helioz2000/RAY_power/Board/IMG_2490.jpg

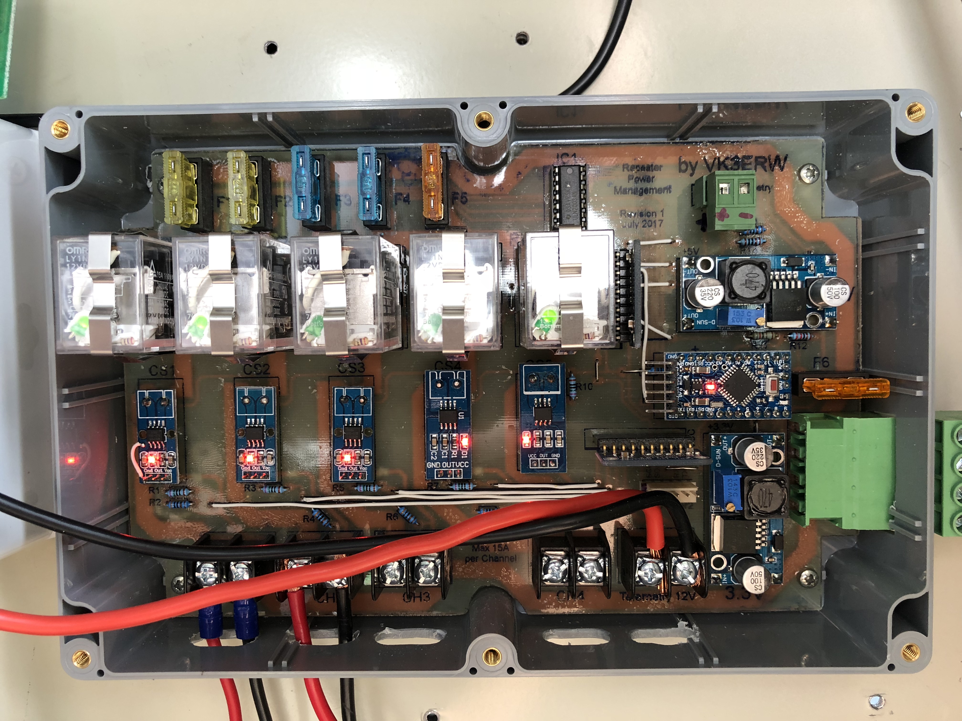
Board/IMG_2490.jpg
