helioz2000/RAY_power/Board/RaPiCable.pdf

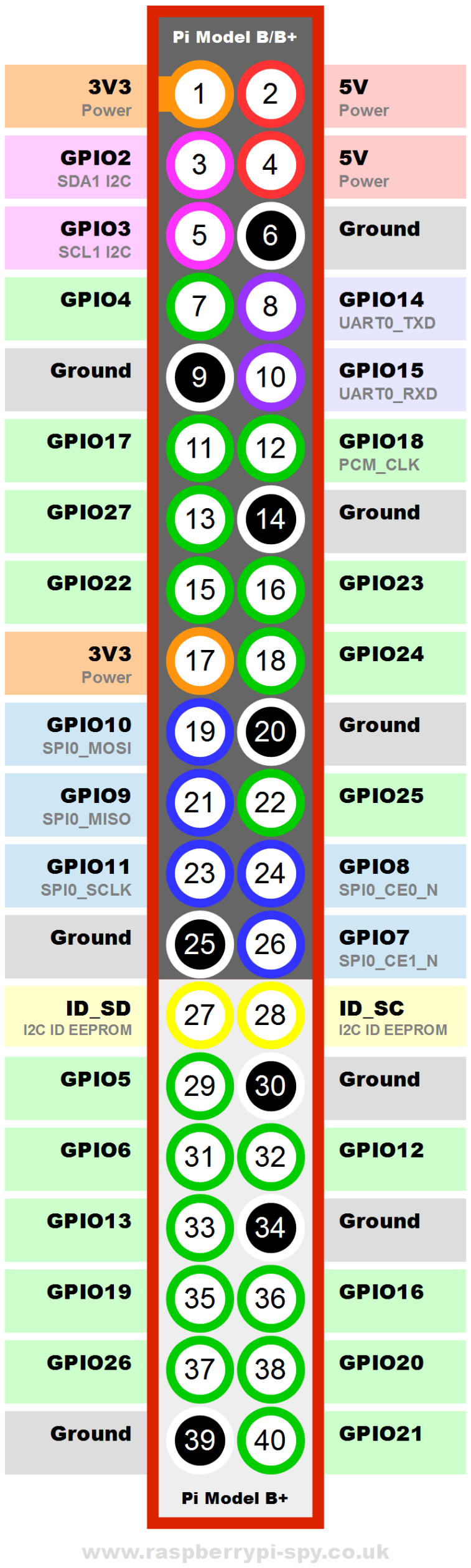
[picture p2: figure]

RaPi | Pwr
1 (NC) 5 | -> | 2 (SCL) 3 | -> | 3 (SDA) 6 | -> | 4 (GND) 8 | -> | 5 (RX)
10 | -> | 6 (TX)

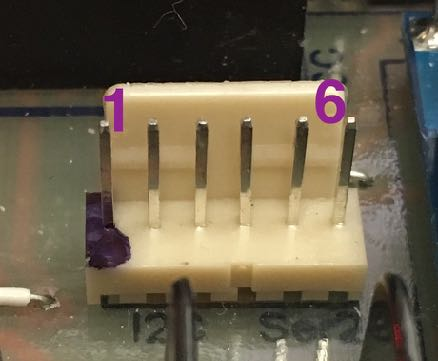
[picture p3: figure]
