helioz2000/RAY_power/Board/RAY_PWR_PartsList.rtf

R1 | 750 | Jaycar
R2 | 3k | Jaycar
R3 | 750 | Jaycar
R4 | 3k | Jaycar
R5 | 750 | Jaycar
R6 | 3k | Jaycar
R7 | 750 | Jaycar
R8 | 3k | Jaycar
R9 | 3k | Jaycar
R10 | 750 | Jaycar
R11 | 8.2k | Jaycar
R12 | 2.2k | Jaycar
R13 | 3k | Jaycar
R14 | 1k | Jaycar
RLY1 | LY1N-DC12 | Omron
RLY2 | LY1N-DC12 | Omron
RLY3 | LY1N-DC12 | Omron
RLY4 | LY1N-DC12 | Omron
RLY5 | MY2N-DC12 | Omron
IC1 | ULN2003AN | Texas Inst.
B1 | Pro Mini 8Mhz 3.3V | Arduino
B2 | ADS1115 | Adafruit
B2 | ADS1115 | Adafruit
B3 | 5V Buck Converter | gowin_electronic (ebay)
B3 | 3.3V Buck Converter | gowin_electronic (ebay)
