helioz2000/RAY_power/Board/RAY_pwr_components.pdf

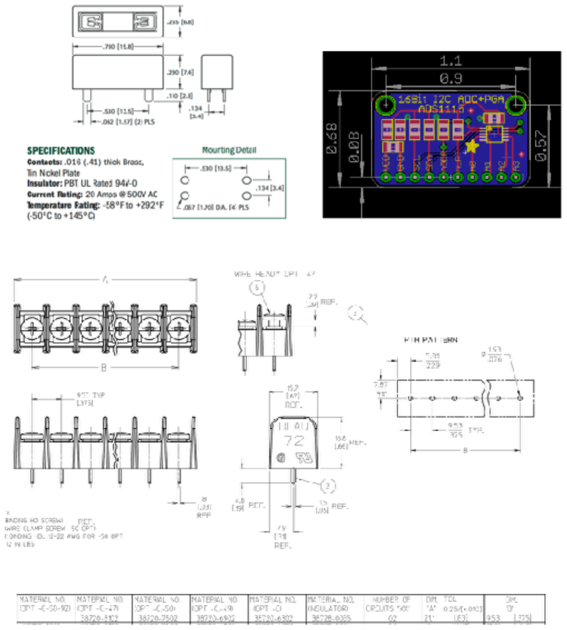
[picture p4: page 1]
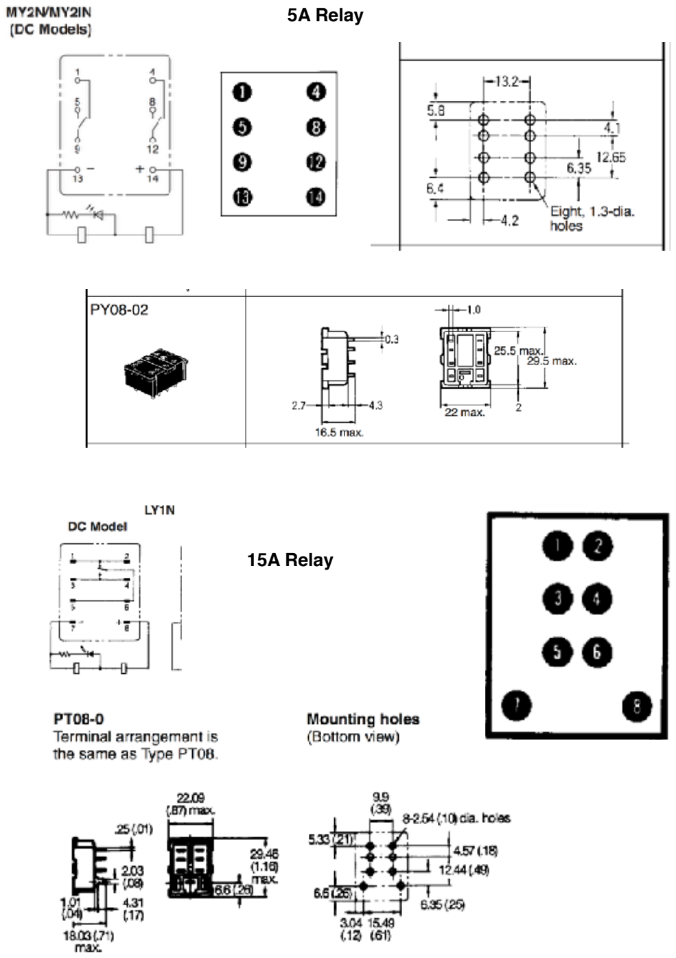
[picture p5: page 2]

15A Relay

5A Relay
