helioz2000/RAY_power/(list of files, cad)

Other CAD files:
Board/RAYPWR_DrillTemplate.dwg
Board/RAY_PWR_PCB.dwg
