helioz2000/RAY_power/Board/ray_pwr.pdf

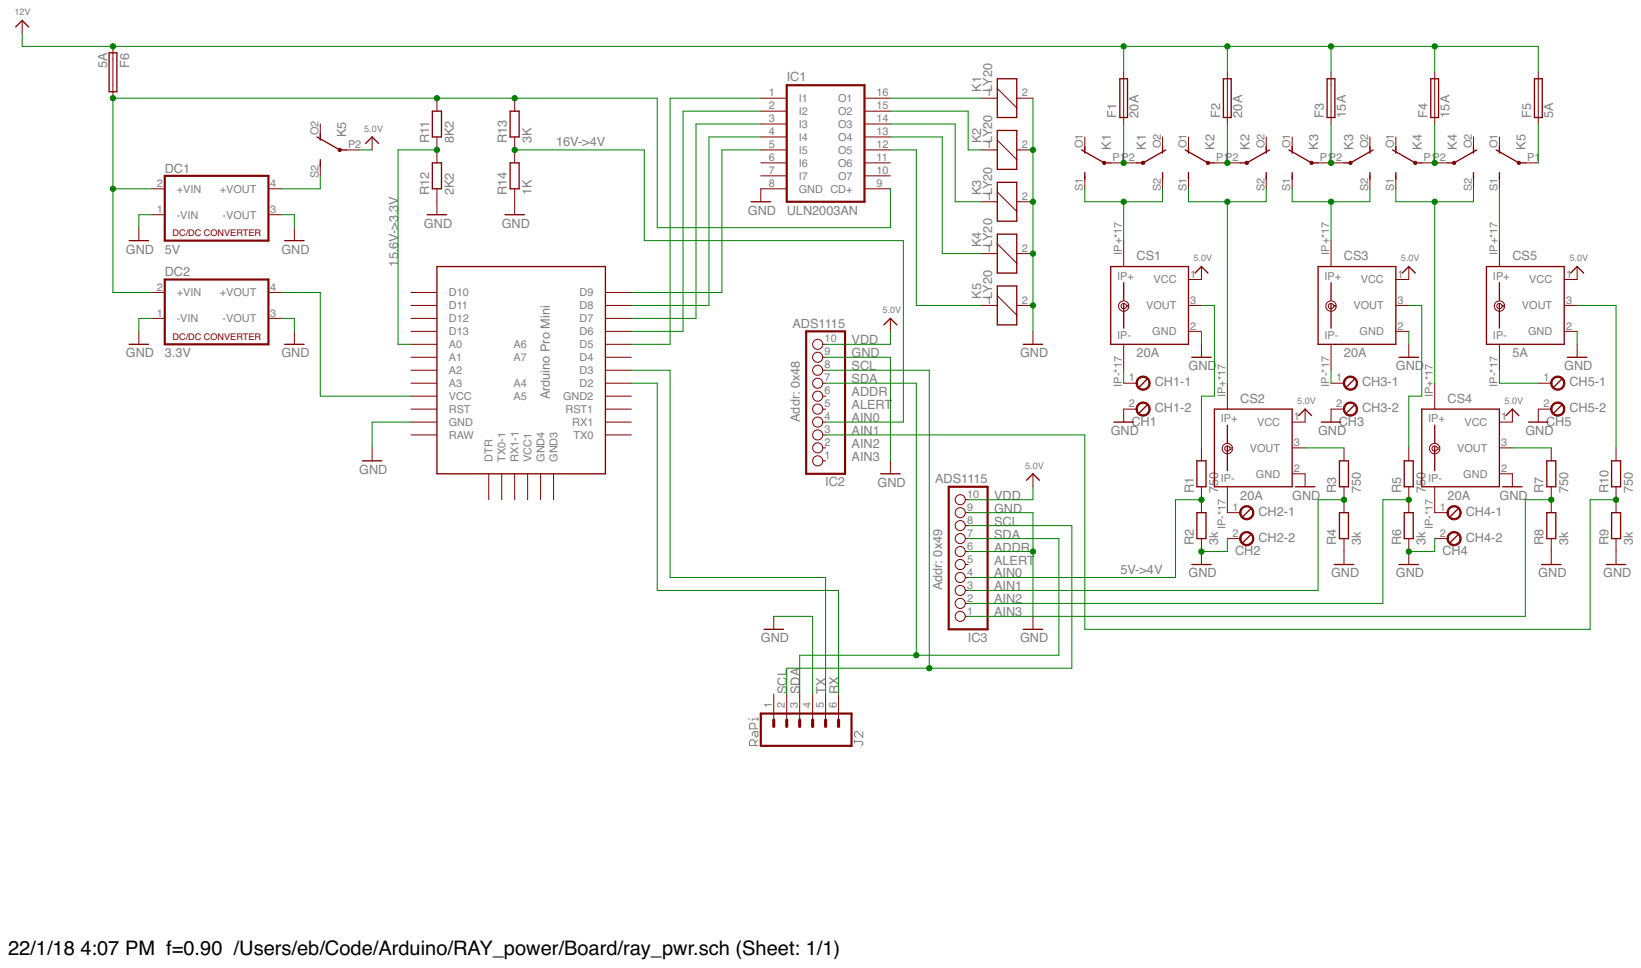
[picture p6: page 1]

22/1/18 4:07 PM f=0.90 /Users/eb/Code/Arduino/RAY_power/Board/ray_pwr.sch (Sheet: 1/1)
