helioz2000/RAY_power/Board/RAY_Power.pdf

# VK2RAY power supply distribution and Ethernet

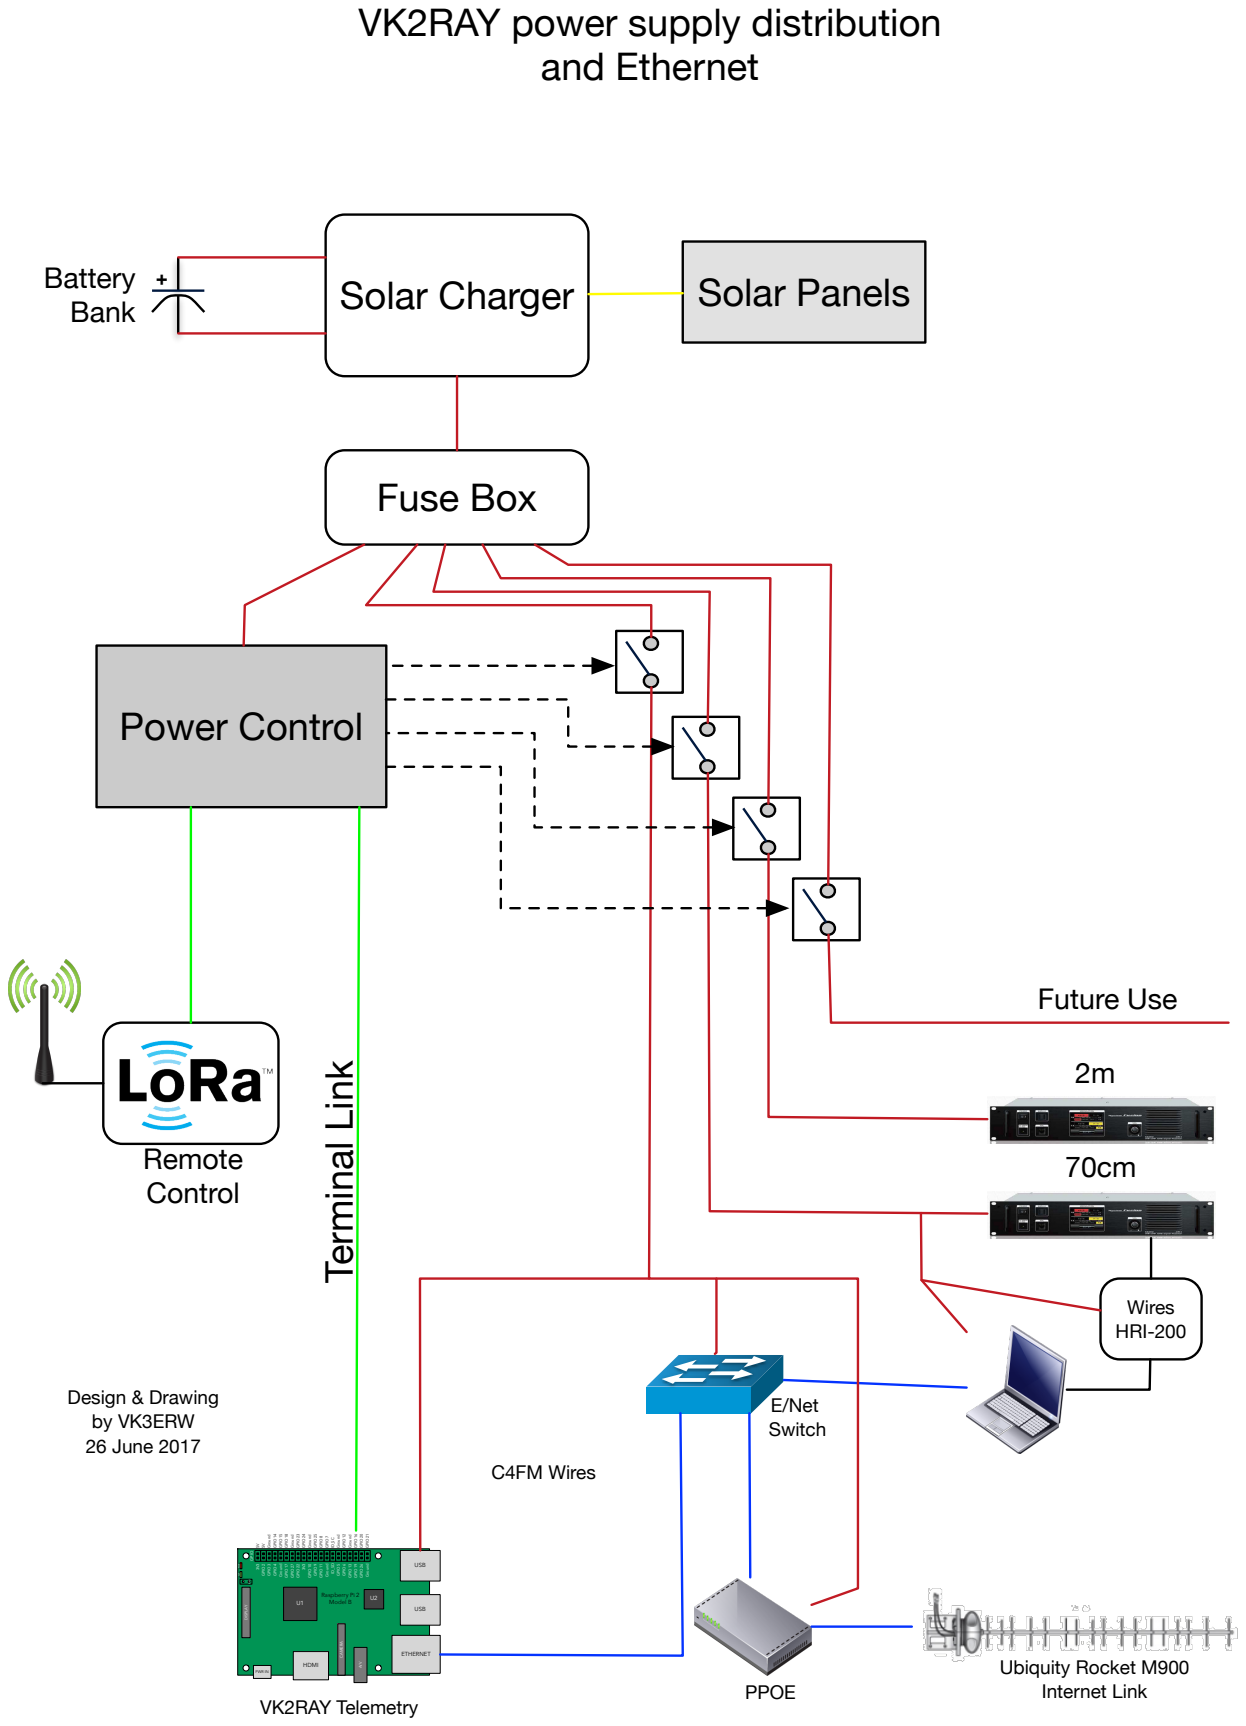
[picture p7: page 1]
Solar Panels; Fuse Box; Future Use; ETHERNET; USB; HDMI; PWR IN; A/V CAMERA; DISPLAY; RUN; ACT PWR; GPIO; GPIO 3; GPIO 11; Ground; GPIO 19; GPIO 2; GPIO 26; GPIO 9; GPIO 17; GPIO 27; GPIO 10; GPIO 4; GPIO 5; GPIO 6; GPIO 22; GPIO 13; GPIO 14; GPIO 15; GPIO 18; GPIO 23; GPIO 24; GPIO 25; GPIO 8; GPIO 7; GPIO 12; GPIO 16; GPIO 20; GPIO 21; Raspberry Pi 2 Model B; PPOE; VK2RAY Telemetry; C4FM Wires; E/Net Switch; Ubiquity Rocket M900 Internet Link; Remote Control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

Battery
Solar Charger ⁺
Bank
Power ControlTerminal Link
