helioz2000/RAY_power/Board/RAY_PWR_PCB.pdf

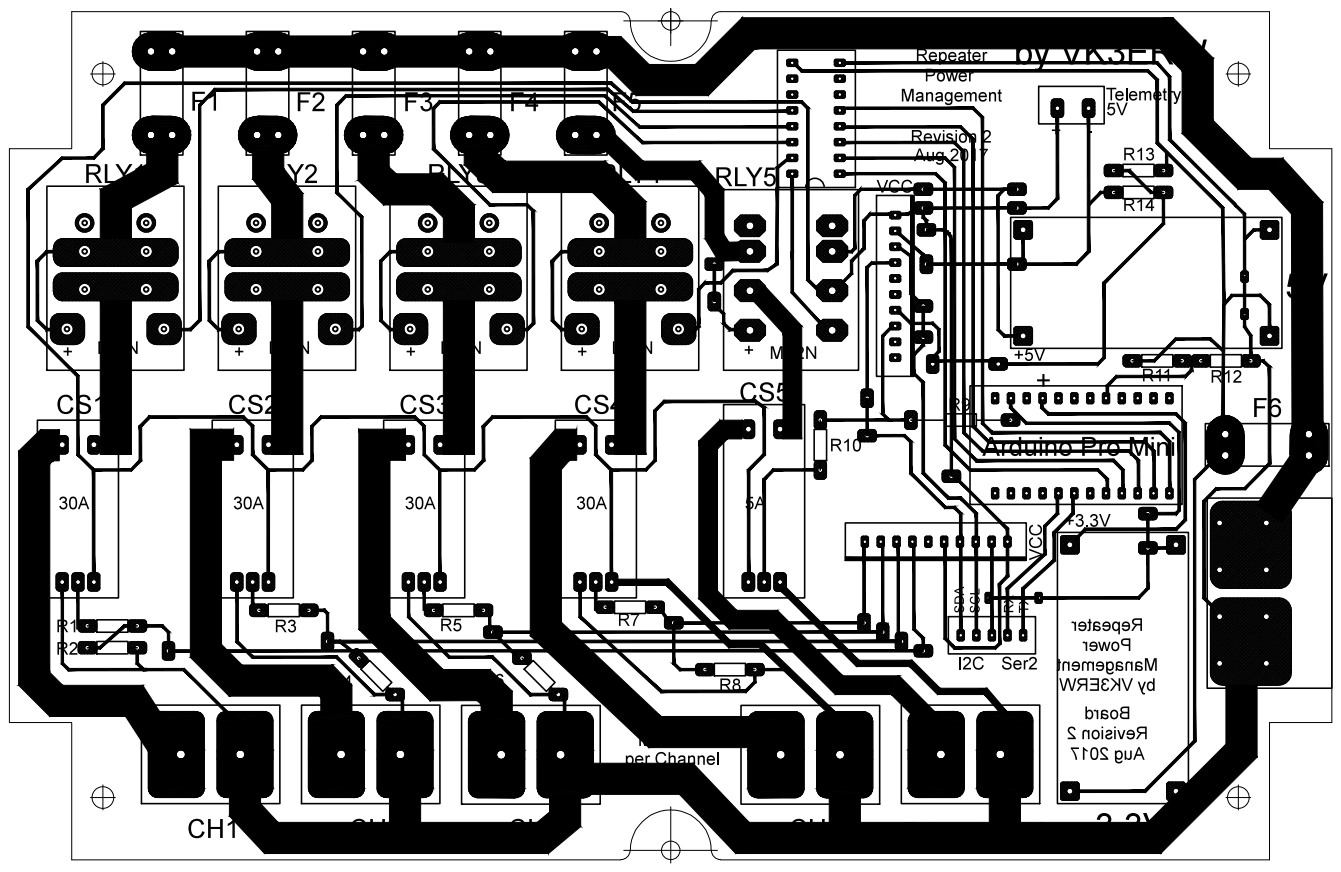
[picture p8: page 1]
