helioz2000/RAY_power/Board/ray_pwr.sch

## EAGLE design Board/ray_pwr.sch (2018-01-22)

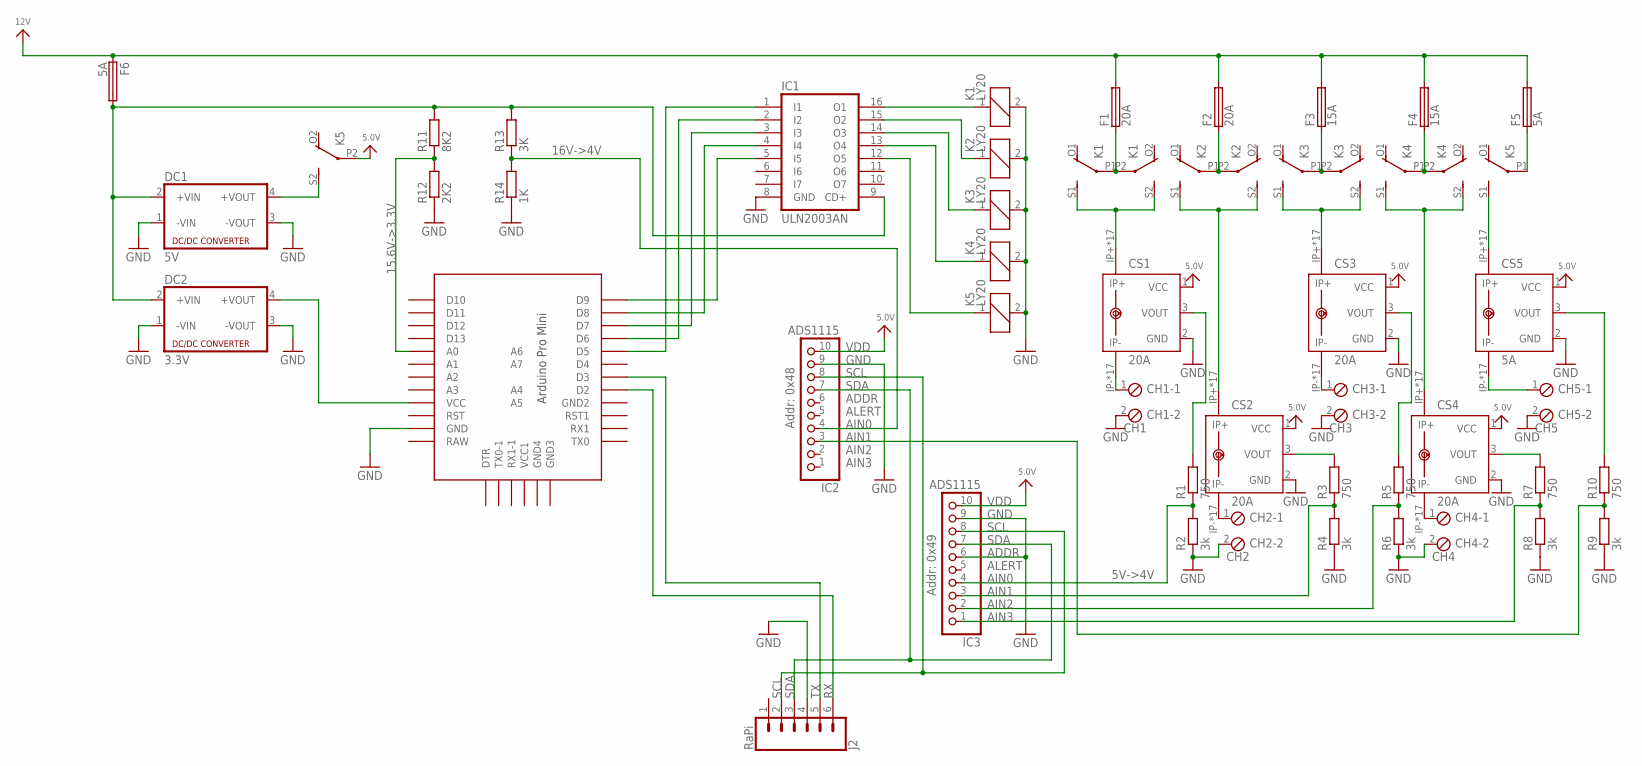
[picture p9: schematic ray_pwr.sch]

Parts:
CH1: CH1; 2POL254
CH2: CH2; 2POL254
CH3: CH3; 2POL254
CH4: CH4; 2POL254
CH5: CH5; 2POL254
CS1, CS2, CS3, CS4: 20A; ACS75050
CS5: 5A; ACS75050
DC1: 5V; 4SIL
DC2: 3.3V; 4SIL
F1, F2: 20A; FUSE_HOLDER_5X20MM
F3, F4: 15A; FUSE_HOLDER_5X20MM
F5, F6: 5A; FUSE_HOLDER_5X20MM
IC1: ULN2003AN; DIL16
IC2, IC3: ADS1115; 1X10_ROUND70
J2: RaPi; MOLEX-1X6
K1, K2, K3, K4, K5: LY20
R1, R3, R5, R7, R10: 750; 0207/10
R2, R4, R6, R8, R9: 3k; 0207/10
R11: 8K2; 0207/10
R12: 2K2; 0207/10
R13: 3K; 0207/10
R14: 1K; 0207/10
U$1: PRO-MINI-2

Connections:
5.0V: CS1.1 (VCC), CS2.1 (VCC), CS3.1 (VCC), CS4.1 (VCC), CS5.1 (VCC), IC2.10, IC3.10, K5.P2
12V: F1.2, F2.2, F3.2, F4.2, F5.2, F6.1
GND: CH1.2, CH2.2, CH3.2, CH4.2, CS1.2 (GND), CS2.2 (GND), CS3.2 (GND), CS4.2 (GND), CS5.2 (GND), DC1.1 (-VIN), DC1.3 (-VOUT), DC2.1 (-VIN), DC2.3 (-VOUT), IC1.8 (GND), IC2.9, IC3.6, IC3.9, K1.2, K2.2, K3.2, K4.2, K5.2, R2.1, R4.1, R6.1, R8.1, R9.1, R12.1, R14.1, U$1.GND
unnamed: DC1.2 (+VIN), DC2.2 (+VIN), F6.2, IC1.9 (CD+), R11.2, R13.2
unnamed: DC1.4 (+VOUT), K5.S2 (S)
unnamed: DC2.4 (+VOUT), U$1.VCC
unnamed: IC1.1 (I1), U$1.D5
unnamed: IC1.2 (I2), U$1.D6
unnamed: IC1.3 (I3), U$1.D7
unnamed: IC1.4 (I4), U$1.D8
unnamed: IC1.5 (I5), U$1.D9
unnamed: R11.1, R12.2, U$1.A0
unnamed: IC2.4, R13.1, R14.2
unnamed: IC1.16 (O1), K1.1
unnamed: IC2.7, IC3.7
unnamed: IC2.8, IC3.8
unnamed: IC1.14 (O3), K3.1
unnamed: IC1.15 (O2), K2.1
unnamed: IC1.13 (O4), K4.1
unnamed: IC1.12 (O5), K5.1
unnamed: F1.1, K1.P1, K1.P2
unnamed: CS1.IP+, K1.S1 (S), K1.S2 (S)
unnamed: F2.1, K2.P1, K2.P2
unnamed: F3.1, K3.P1, K3.P2
unnamed: F4.1, K4.P1, K4.P2
unnamed: F5.1, K5.P1
unnamed: CS2.IP+, K2.S1 (S), K2.S2 (S)
unnamed: CS3.IP+, K3.S1 (S), K3.S2 (S)
unnamed: CS4.IP+, K4.S1 (S), K4.S2 (S)
unnamed: CS5.IP+, K5.S1 (S)
unnamed: CS1.3 (VOUT), R1.2
unnamed: CS3.3 (VOUT), R5.2
unnamed: IC3.4, R1.1, R2.2
unnamed: IC3.3, R3.1, R4.2
unnamed: IC3.2, R5.1, R6.2
unnamed: IC3.1, R7.1, R8.2
unnamed: IC2.3, R9.2, R10.1
unnamed: CS5.3 (VOUT), R10.2
unnamed: CH2.1, CS2.IP-
unnamed: CH4.1, CS4.IP-
unnamed: CH1.1, CS1.IP-
unnamed: CH3.1, CS3.IP-
unnamed: CH5.1, CS5.IP-

Notes on the sheet:
AIN3
AIN2
AIN1
AIN0
ALERT
ADDR
SDA
SCL
GND
VDD
15.6V->3.3V
16V->4V
5V->4V
Addr: 0x48
Addr: 0x49
