helioz2000/RAY_power/power.cpp

/* Arduino Power saving code
 *  credit to  EA5HAV Javi (from his trackuino project)
 *
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
 * You should have received a copy of the GNU General Public License
 * along with this program; if not, write to the Free Software
 * Foundation, Inc., 51 Franklin Street, Fifth Floor, Boston, MA  02110-1301, USA.
 */

#include <avr/power.h>
#include <avr/interrupt.h>
#include <avr/sleep.h>
#if (ARDUINO + 1) >= 100
#  include <Arduino.h>
#else
#  include <WProgram.h>
#endif

#define LED_PIN LED_BUILTIN

#include "power.h"

/****** Power Saving Selay ******/
void psDelay(uint32_t delay_time) {
  uint32_t timeout = millis() + delay_time;
  while(1) {
    if ((int32_t) (millis() - timeout) >= 0) {
      return;
    }
  power_save();
  }
}

void disable_bod_and_sleep()
{
  /* This will turn off brown-out detection while
   * sleeping. Unfortunately this won't work in IDLE mode.
   * Relevant info about BOD disabling: datasheet p.44
   *
   * Procedure to disable the BOD:
   *
   * 1. BODSE and BODS must be set to 1
   * 2. Turn BODSE to 0
   * 3. BODS will automatically turn 0 after 4 cycles
   *
   * The catch is that we *must* go to sleep between 2
   * and 3, ie. just before BODS turns 0.
   */
  unsigned char mcucr;

  cli();
  mcucr = MCUCR | (_BV(BODS) | _BV(BODSE));
  MCUCR = mcucr;
  MCUCR = mcucr & (~_BV(BODSE));
  sei();
  sleep_mode();    // Go to sleep
}

void power_save()
{
  /* Enter power saving mode. SLEEP_MODE_IDLE is the least saving
   * mode, but it's the only one that will keep the UART running.
   */

  set_sleep_mode(SLEEP_MODE_IDLE);
  sleep_enable();
  power_all_disable();
  power_usart0_enable();
  /*
  power_adc_disable();
  power_spi_disable();
  power_twi_disable();
  power_timer0_disable();
  power_timer1_disable();
  power_timer2_disable();
  */
  
  digitalWrite(LED_PIN, LOW);
  sleep_mode();    // Go to sleep
  digitalWrite(LED_PIN, HIGH);
  
  sleep_disable();  // Resume after wake up
  power_all_enable();
}
