helioz2000/RAY_power/(commit log)

2017-06-25 Battery Monitor & Cutoff, Initial Release 2016
    Commissioned in 2016 and installed on site
2017-06-27 wip - basic terminal & voltage reading
2017-07-21 Added PCB
    added PCB drawing in Autocad
    [RAY_PWR_PCB.dwg]
2017-07-23 PCB drawing
    [RAY_PWR_PCB.dwg]
2017-07-24 Board drawing updated
    [RAY_PWR_PCB.dwg]
2017-07-24 Board Updated Rev 1
    [RAY_PWR_PCB.dwg]
2017-07-25 PCB Rev1 update
    [RAY_PWR_PCB.dwg]
2017-07-25 PCB update
    added trial transfer boards to layout
    [RAY_PWR_PCB.dwg]
2017-07-28 PCB update
    [RAY_PWR_PCB.dwg]
2017-07-29 PCB Rev 2
    Corrections for board layout errors
    [RAY_PWR_PCB.dwg]
2017-07-30 PCB Rev 2 update
    [RAY_PWR_PCB.dwg]
2017-08-02 updated voltage settings
2017-08-21 Move Strings to Flash
    Strings stored in Flash
    Voltages now stored as byte
2017-08-22 Device config now stored in EEPROM
2017-08-23 RaPi cable added
2017-08-29 Current draw info added
2018-01-19 Additional Documentation and Drill Template
    [RAYPWR_DrillTemplate.dwg]
2018-01-22 Eagle circuit added
    [ray_pwr.sch]
2018-11-13 board update
2019-06-12 Update RAY_power.ino
    V2.1 - added battery voltage software filter
